MaxMadeGG/-Chickbot-/big-main-leg-motor.stl

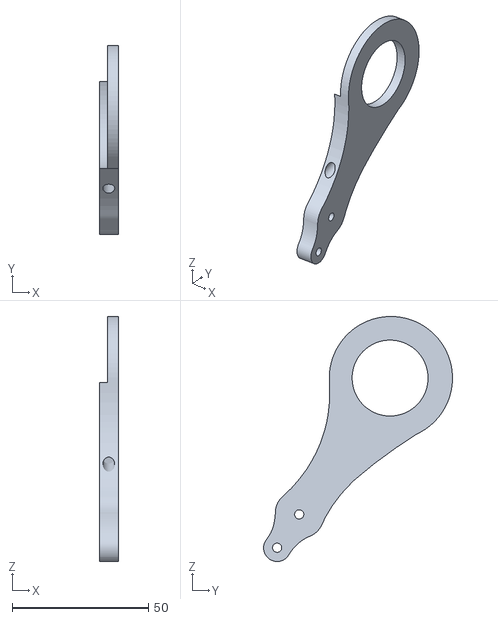
[picture p1: CAD file, 2026-11-01]
big-main-leg-motor.stl
7.00 x 69.4 x 90.0
