MaxMadeGG/-Chickbot-/tire-full.stl

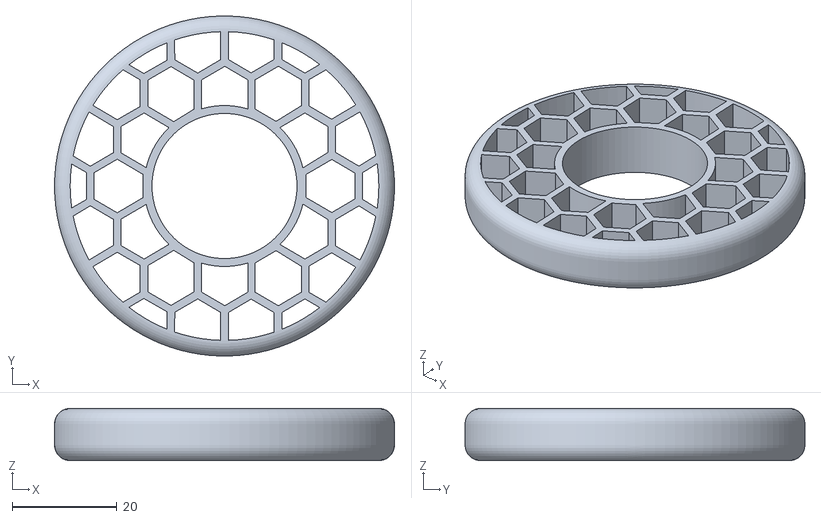
[picture p2: CAD file, 2026-10-26]
tire-full.stl
65.0 x 65.0 x 10.0
