MaxMadeGG/-Chickbot-/chickbot-shell-side2-full.stl

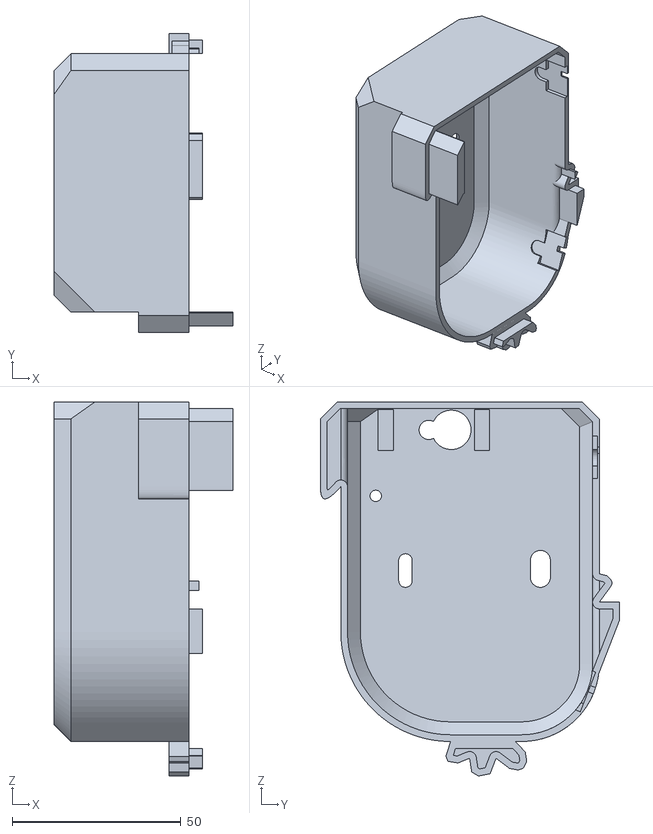
[picture p3: CAD file, 2026-10-26]
chickbot-shell-side2-full.stl
53.0 x 88.7 x 110.8
