MaxMadeGG/-Chickbot-/chickbot-body-full.stl

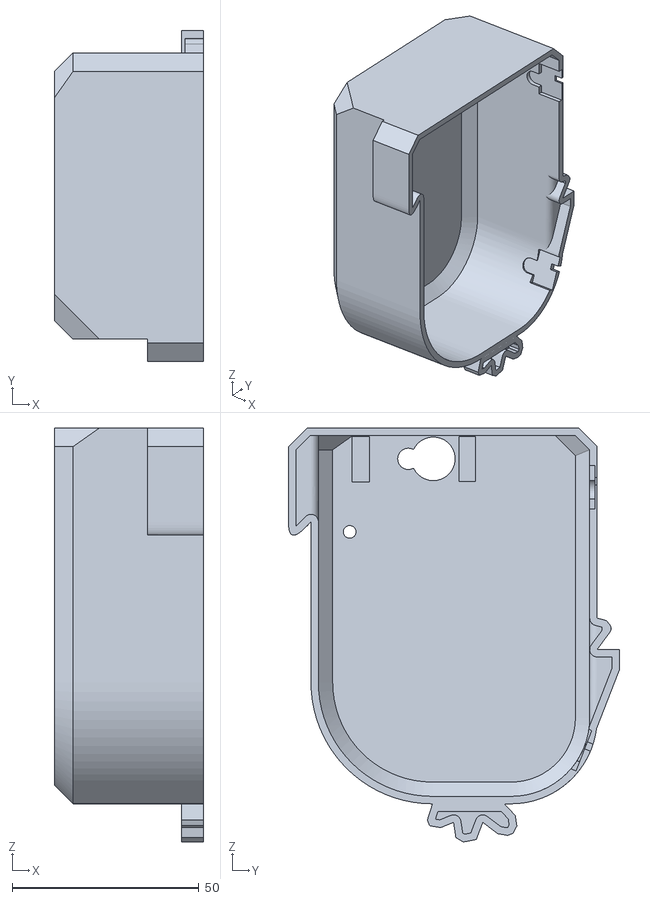
[picture p4: CAD file, 2026-10-16]
chickbot-body-full.stl
40.0 x 88.7 x 110.8
