MaxMadeGG/-Chickbot-/motor-leg-cover.stl

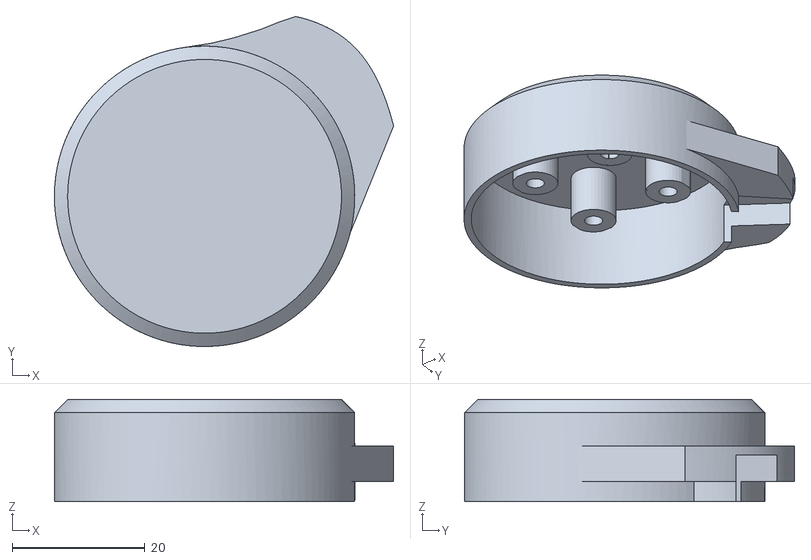
[picture p5: CAD file, 2026-11-01]
motor-leg-cover.stl
51.1 x 49.7 x 15.4
