MaxMadeGG/-Chickbot-/leg-deco-hold-plate-thingy.stl

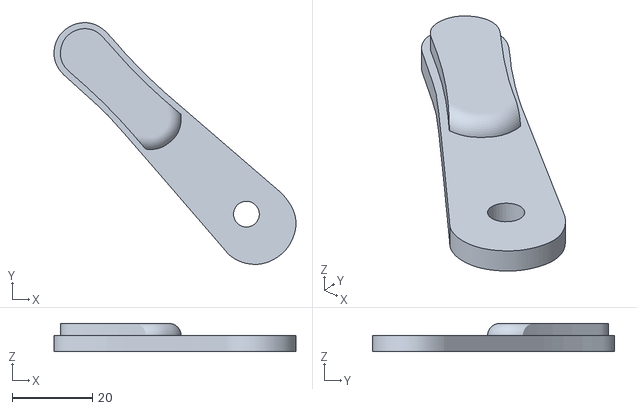
[picture p6: CAD file, 2026-11-01]
leg-deco-hold-plate-thingy.stl
60.2 x 60.1 x 7.00
