MaxMadeGG/-Chickbot-/self balancing robot.step

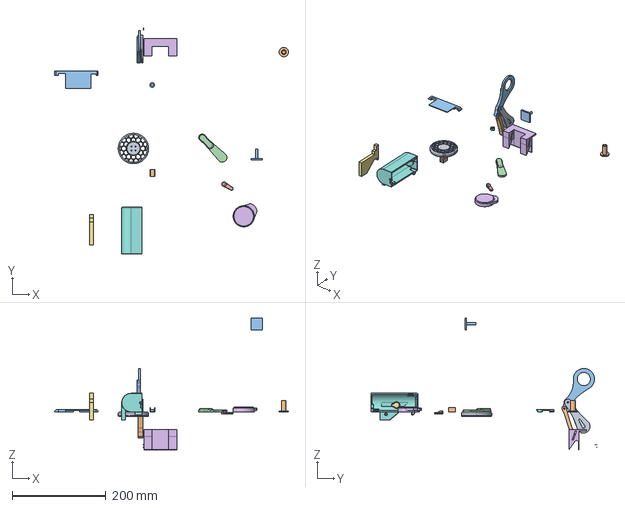
[picture p7: CAD file, 2026-10-31]
self balancing robot.step
498.0 x 480.6 x 280.7 mm
