MaxMadeGG/-Chickbot-/battery-holder.stl

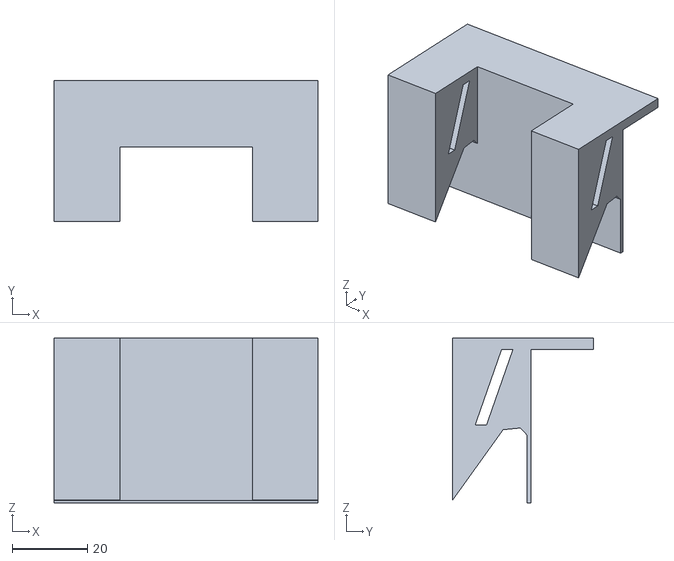
[picture p8: CAD file, 2026-10-26]
battery-holder.stl
70.0 x 37.3 x 43.7
