MaxMadeGG/-Chickbot-/wheel-rim-test.stl

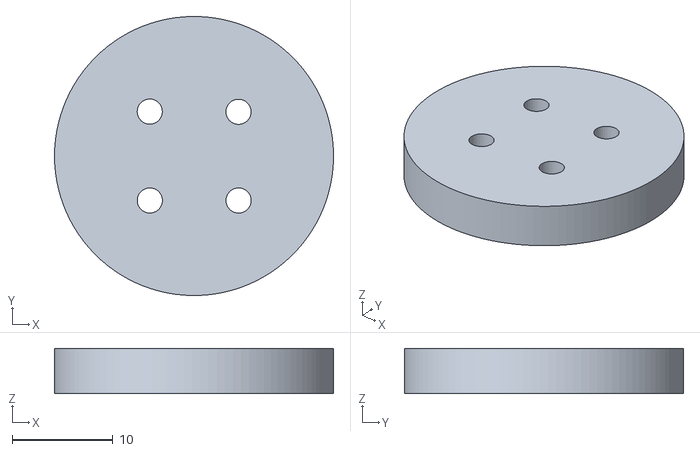
[picture p9: CAD file, 2026-10-26]
wheel-rim-test.stl
27.7 x 27.7 x 4.50
