MaxMadeGG/-Chickbot-/(list of files, cad)

Other CAD files:
tire-rim-test.stl
self balancing robot.f3z
