MaxMadeGG/-Chickbot-/(commit log)

2026-10-26 Update README with new demo link and file references
    Updated demo link and removed file references for gerber, schematic, and PCB.
2026-10-31 Change 'Schematic and PCB' to 'Wiring'
    Updated section headers and removed schematic references.
